cuspaceflight/si4463-breakout/schematics/si4463-breakout.kicad_pcb

## KiCad design schematics/si4463-breakout.kicad_pcb (2022-01-27)

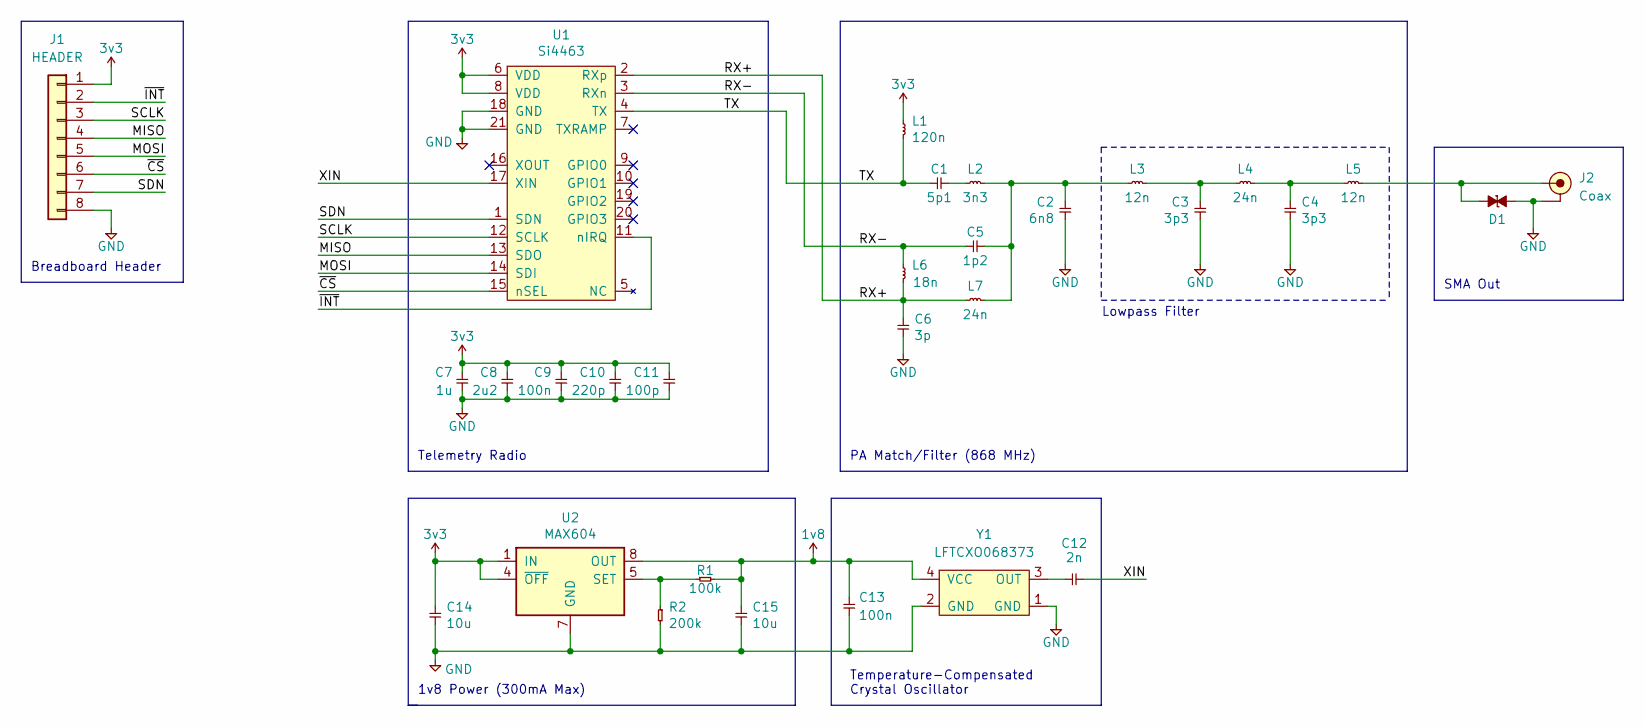
[picture p1: schematic si4463-breakout.kicad_sch, Lychee Flight Computer]

Parts:
C1: 5p1; C_0402; Farnell 2781439
C2: 6n8; C_0402; Farnell 2627370
C3, C4: 3p3; C_0402; Farnell 3013357
C5: 1p2; C_0402; Farnell 3369062
C6: 3p; C_0402; Farnell 1758933
C7: 1u; C_0402; Farnell 9402063
C8: 2u2; C_0402; Farnell 2672111
C9, C13: 100n; C_0402; Farnell 9402047
C10: 220p; C_0402; Farnell 3019240
C11: 100p; C_0402; Farnell 2906905
C12: 2n; C_0402; Farnell 2332520
C14, C15: 10u; C_0402; Farnell 3369188
D1: D_ESD; D_0402; Farnell 2368169
J1: HEADER; Header_Breadboard_1x08; Farnell 1022256
J2: Coax; SMA-Edge; Farnell 1608592
L1: 120n; L_0402; Farnell 3471254
L2: 3n3; L_0402; Farnell 1343068
L3, L5: 12n; L_0402; Farnell 1343082
L4, L7: 24n; L_0402; Farnell 3263549
L6: 18n; L_0402; Farnell 1343084
R1: 100k; R_0402; Farnell 2447094
R2: 200k; R_0402; Farnell 2059185
U1: Si4463; Farnell 2462637
U2: MAX604; Farnell 2799174
Y1: LFTCXO068373; Farnell 2627327

Connections:
1v8: C13.1, C15.1, R1.2, U2.8 (OUT), Y1.4 (VCC)
3v3: C7.1, C8.1, C9.1, C10.1, C11.1, C14.1, J1.1, L1.1, U1.6 (VDD), U1.8 (VDD), U2.1 (IN), U2.4 (~OFF)
/MISO: J1.4, U1.13 (SDO)
/MOSI: J1.5, U1.14 (SDI)
/RX+: C6.1, L6.2, L7.1, U1.2 (RXp)
/RX-: C5.1, L6.1, U1.3 (RXn)
/SCLK: J1.3, U1.12 (SCLK)
/SDN: J1.7, U1.1 (SDN)
/TX: C1.1, L1.2, U1.4 (TX)
/XIN: C12.2, U1.17 (XIN)
/~CS: J1.6, U1.15 (nSEL)
/~INT: J1.2, U1.11 (nIRQ)
GND: C2.2, C3.2, C4.2, C6.2, C7.2, C8.2, C9.2, C10.2, C11.2, C13.2, C14.2, C15.2, D1.2, J1.8, J2.2 (GND), R2.2, U1.18 (GND), U1.21 (GND), U2.2 (GND), U2.3 (GND), U2.6 (GND), U2.7 (GND), Y1.1 (GND), Y1.2 (GND)
unnamed: C1.2, L2.1
unnamed: C2.1, C5.2, L2.2, L3.1, L7.2
unnamed: C3.1, L3.2, L4.1
unnamed: C4.1, L4.2, L5.1
unnamed: C12.1, Y1.3 (OUT)
unnamed: D1.1, J2.1 (RF), L5.2
unnamed: R1.1, R2.1, U2.5 (SET)

Notes on the sheet:
PA Match/Filter (868 MHz)
Lowpass Filter
1v8 Power (300mA Max)
Telemetry Radio
Temperature-Compensated Crystal Oscillator
SMA Out
Breadboard Header

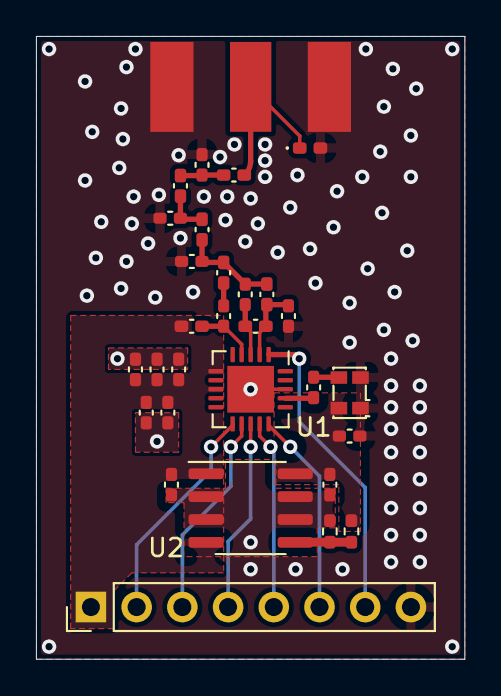
[picture p2: board si4463-breakout.kicad_pcb from above]

Board: 2 copper layers, 23.8 x 34.6 mm, 30 parts (0 on the bottom side), 20 nets.
